tomasinfante/Diseno-Electrico-Capstone/Codigos/Raspberry/foto_20260909_120250.jpg

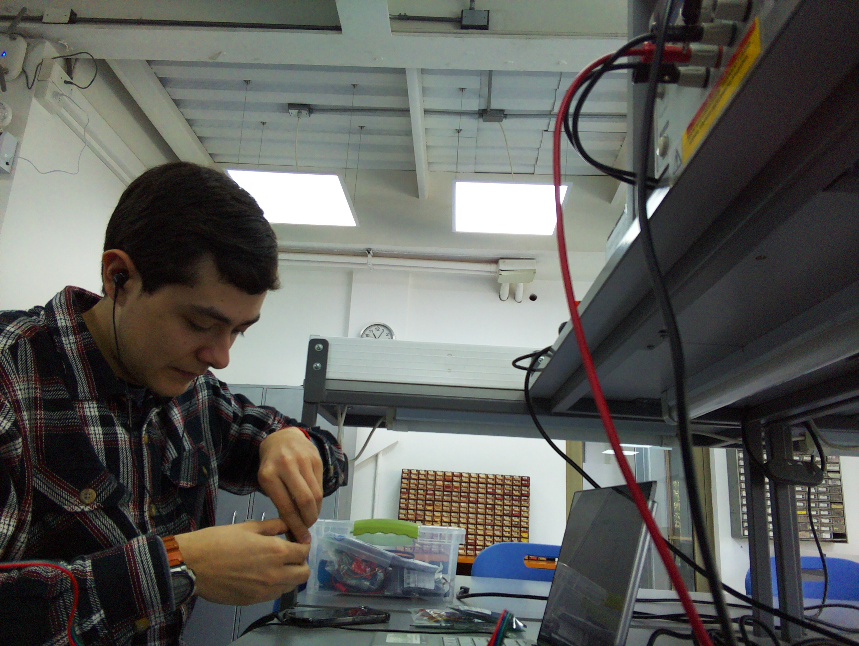
Codigos/Raspberry/foto_20260909_120250.jpg
