tomasinfante/Diseno-Electrico-Capstone/Entregas/Presentación Diseño y Planificación.pdf

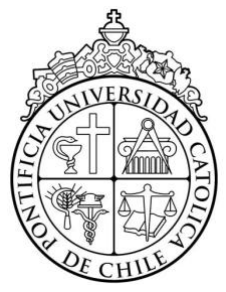
[picture p2: figure]

# Presentación Diseño y Planificación

Diseño Eléctrico – IEE2913 Profesor Tito Arévalo
Ayudantes Joaquín Bocaz y Andrés Mendoza

Grupo 8
Pablo del Campo
Tomás Infante
Juan Pablo Navarro

## Sistema Pan-Tilt para seguimiento automático

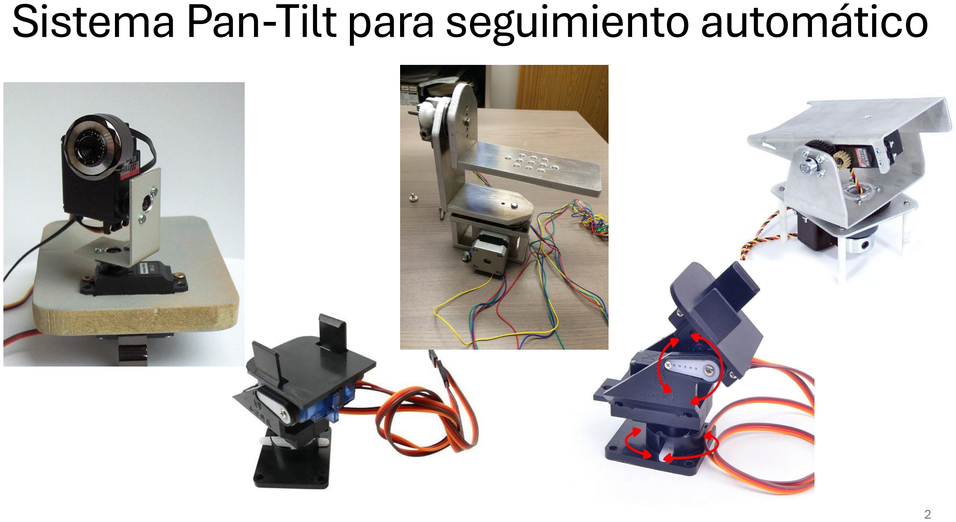
[picture p3: page 2]

## Requerimientos

Movimiento | Seguimiento | Robustez | Monitoreo
Pan + Tilt | Objeto móvil | Oclusión/Perturbación | Variables del sistema
180° por eje | Control automático | Operación segura | Registro de datos

Nuestro problema prioriza posicionamiento controlado, seguimiento y robustez.

## Arquitectura Mecánica

Priorizamos control robusto e independiente por eje

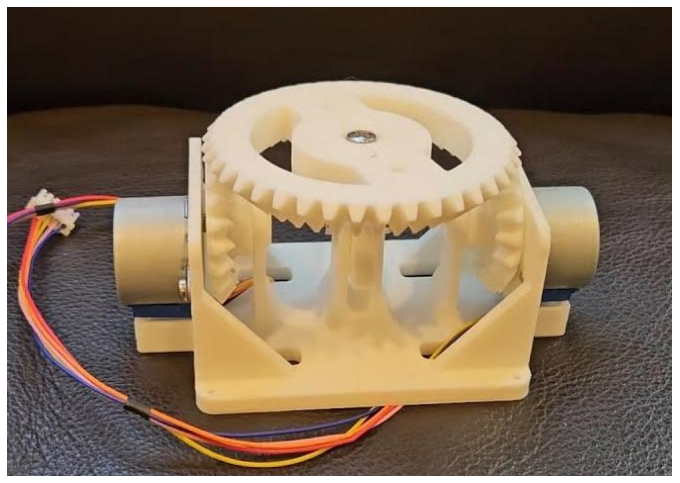
[picture p4: figure]
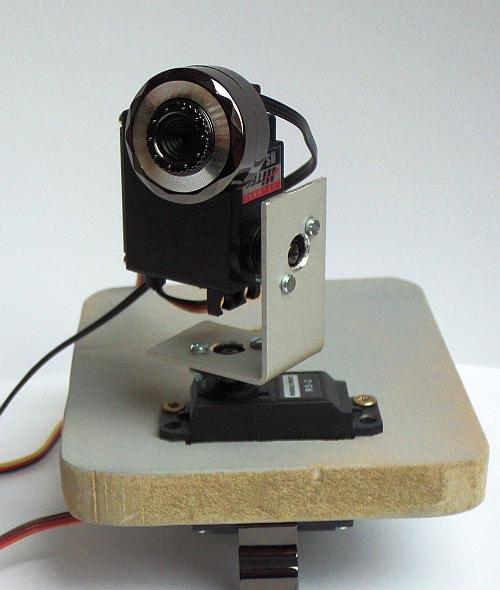
[picture p5: figure]

Diferencial | Independiente
Mejor reparto de la carga | Control desacoplado
Movimiento combinado naturalmente | Diagnostico modular
Mayor complejidad de control | Implementación 3D compleja

## Actuadores

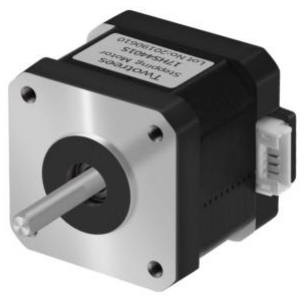
[picture p6: figure]

Motor | Movimiento | Desempeño a baja velocidad | Consideraciones

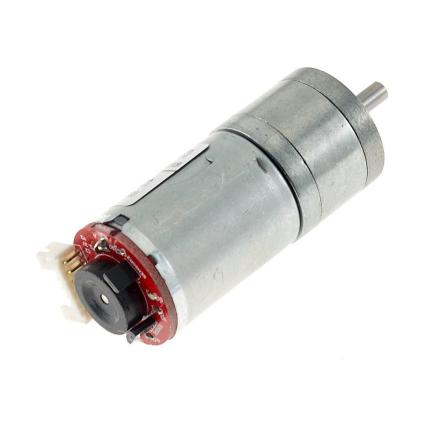
[picture p7: figure]

Paso a paso | Incremental | Alto | Cambios poco precisos en posición a falta de pasos
DC | Continuo | Bajo | Requiere de caja reductora

La aplicación prioriza posicionamiento, no alta velocidad

## ¿Por qué NEMA 17 17HS4401?

- Suficiente capacidad sin
sobredimensionar
- 40 N·cm es un torque adecuado

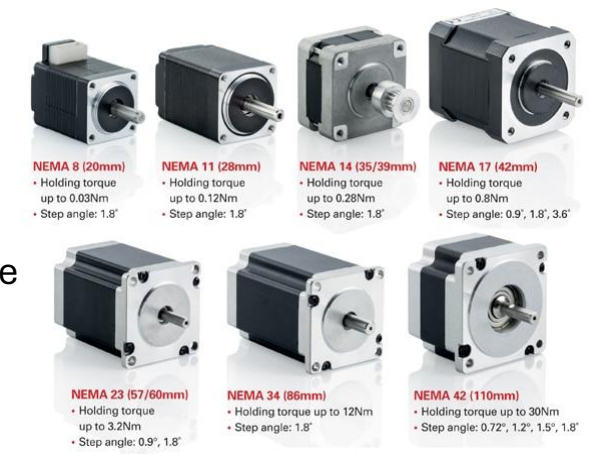
[picture p8: figure]

- 1,5 A/fase nos deja una electronica de potencia manejable
- 1,8°/paso entrega margen de angulo bajo y reducible con microstepping

## Sensor AS5600

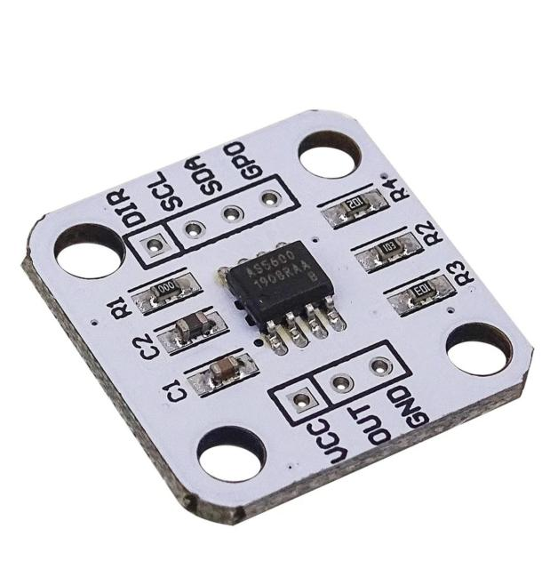
[picture p9: figure]
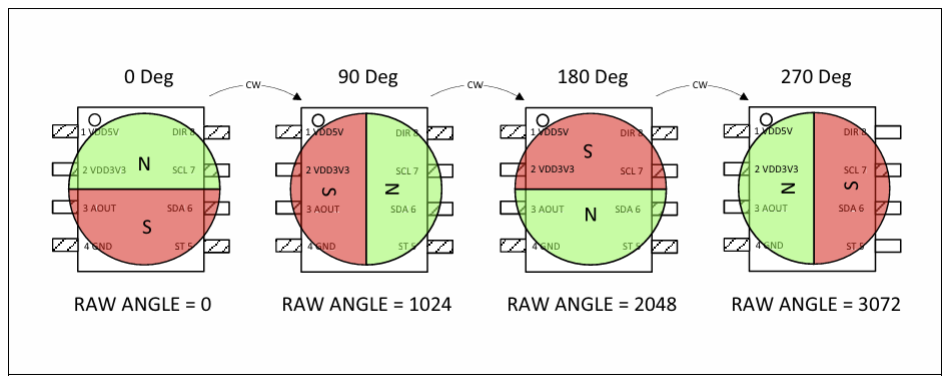
[picture p10: figure]

- 12 bits de resolución para medición de posición.
- Comunicación por medio de I2C
- Gran compatibilidad con motor 17HS4401

## Driver: DRV8825

Actuación y sensado con granularidades compatibles
- Soporte de hasta 2.5 A
- Buen comportamiento
y sinergia con steppers

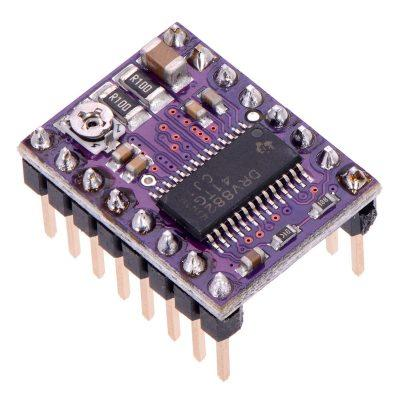
[picture p11: figure]

- Uso de DIR/STEP
- 1/32 microstepping
- 0.056° de resolución

## Bosquejos de Solución

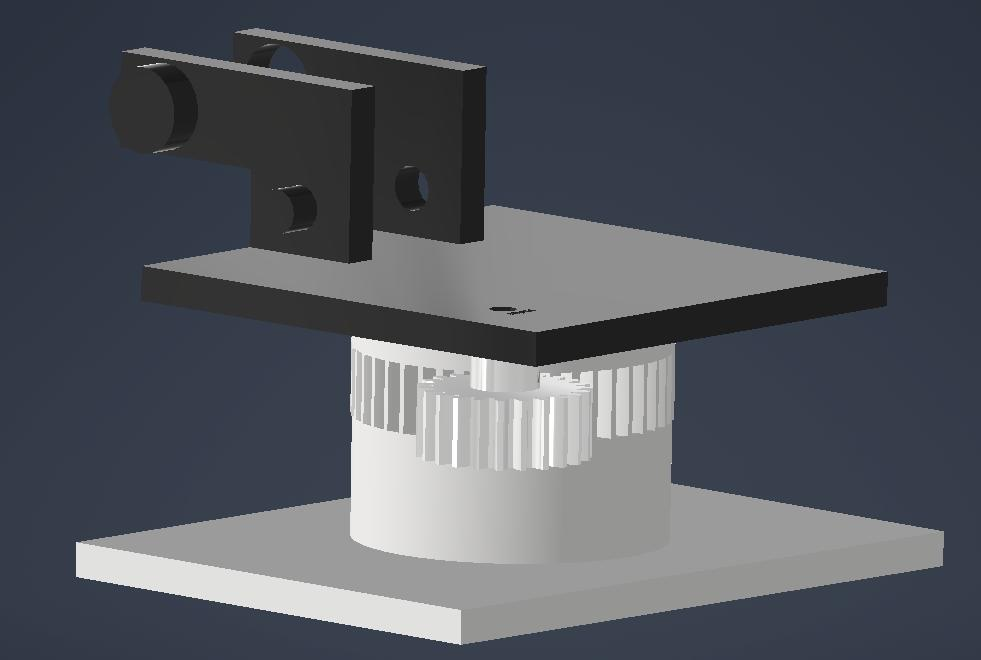
[picture p12: figure]

## Bosquejos de Solución

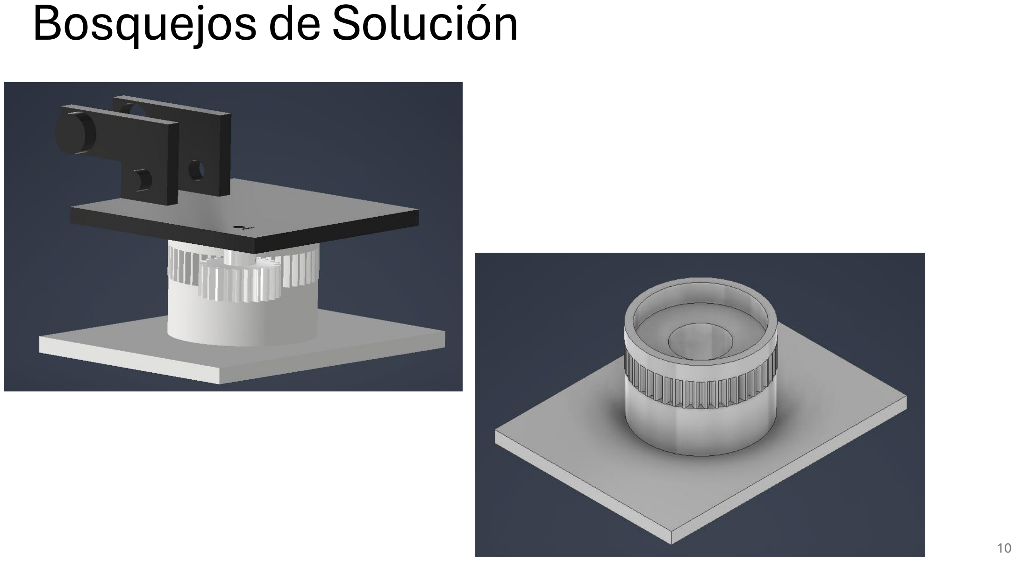
[picture p13: page 10]

## Bosquejos de Solución

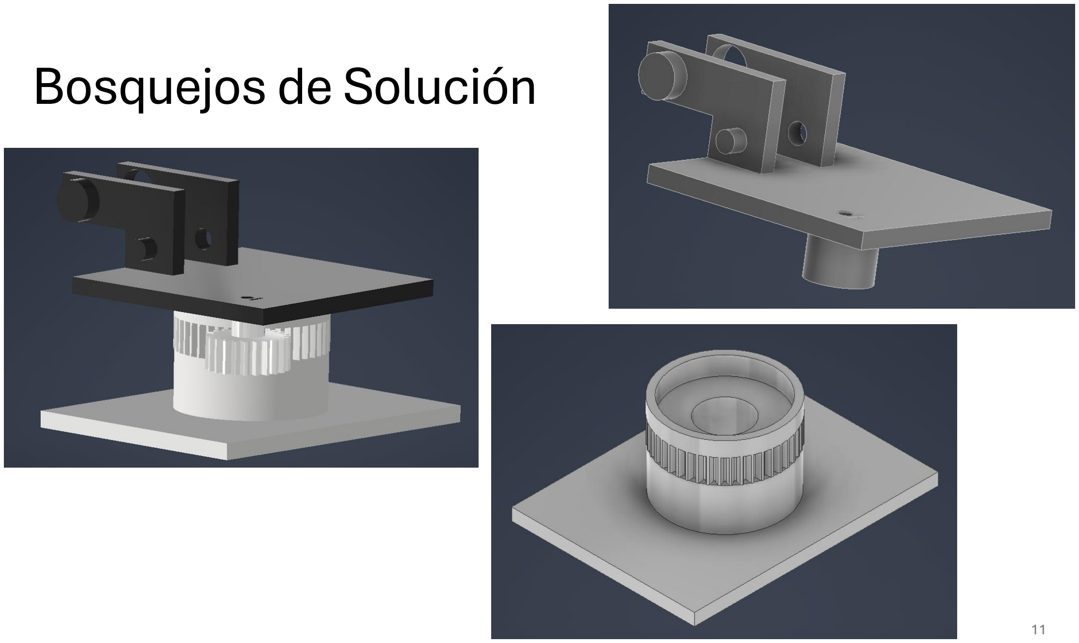
[picture p14: page 11]

## Diagrama del Sistema

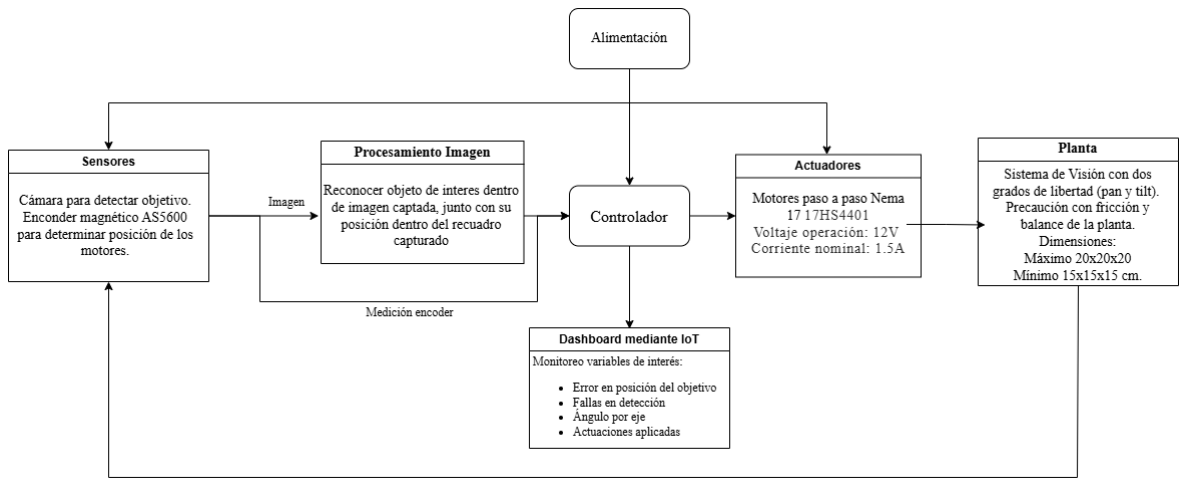
[picture p15: figure]

## Planificación semestral

### Avance 1: Definición formal Sistema

### Avance 2: Implementación Sistema Físico Preliminar

### Avance 3: Implementación de Control

### Entrega final: Prototipo totalmente funcional

## Avance 5%

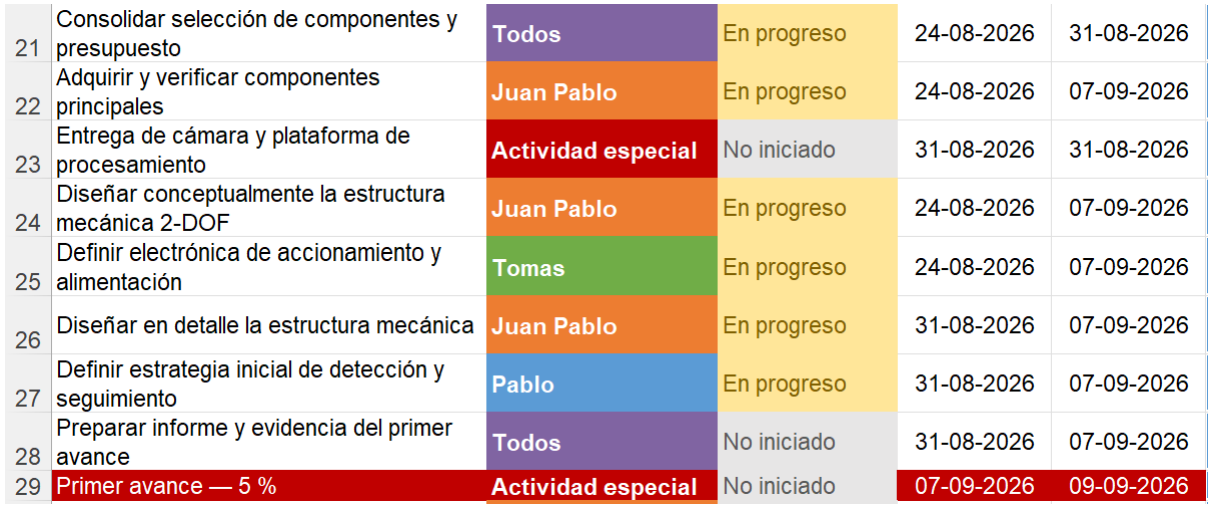
[picture p16: figure]

## Avance 25%

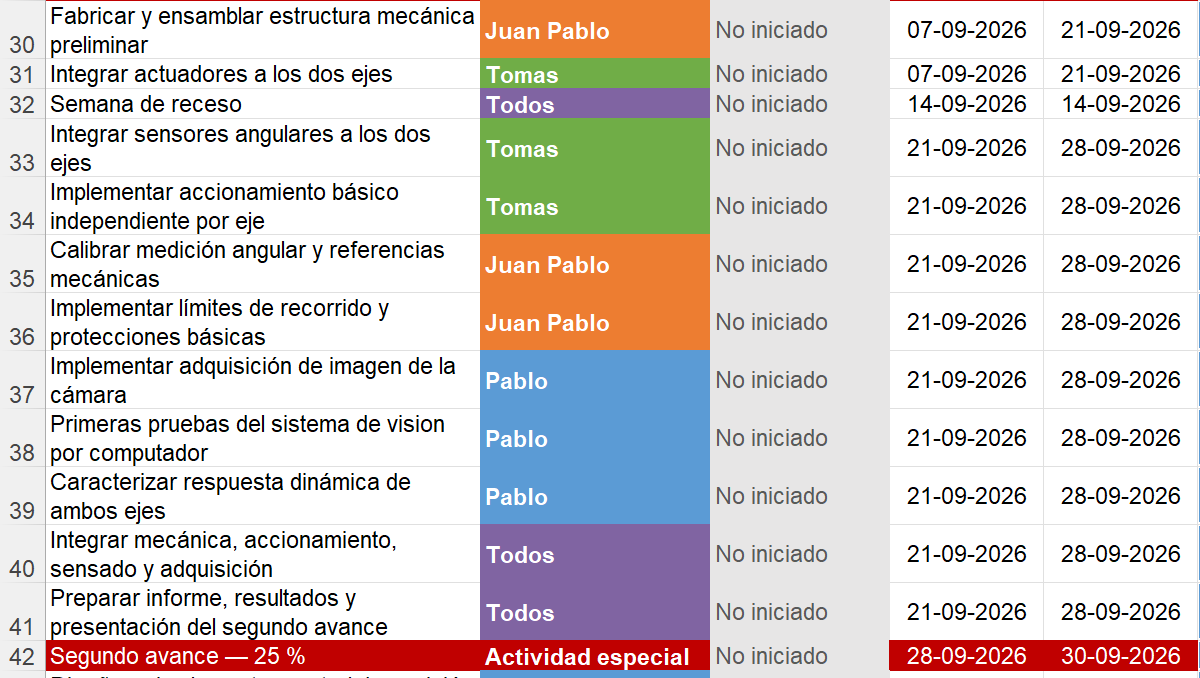
[picture p17: figure]

## Avance 60%

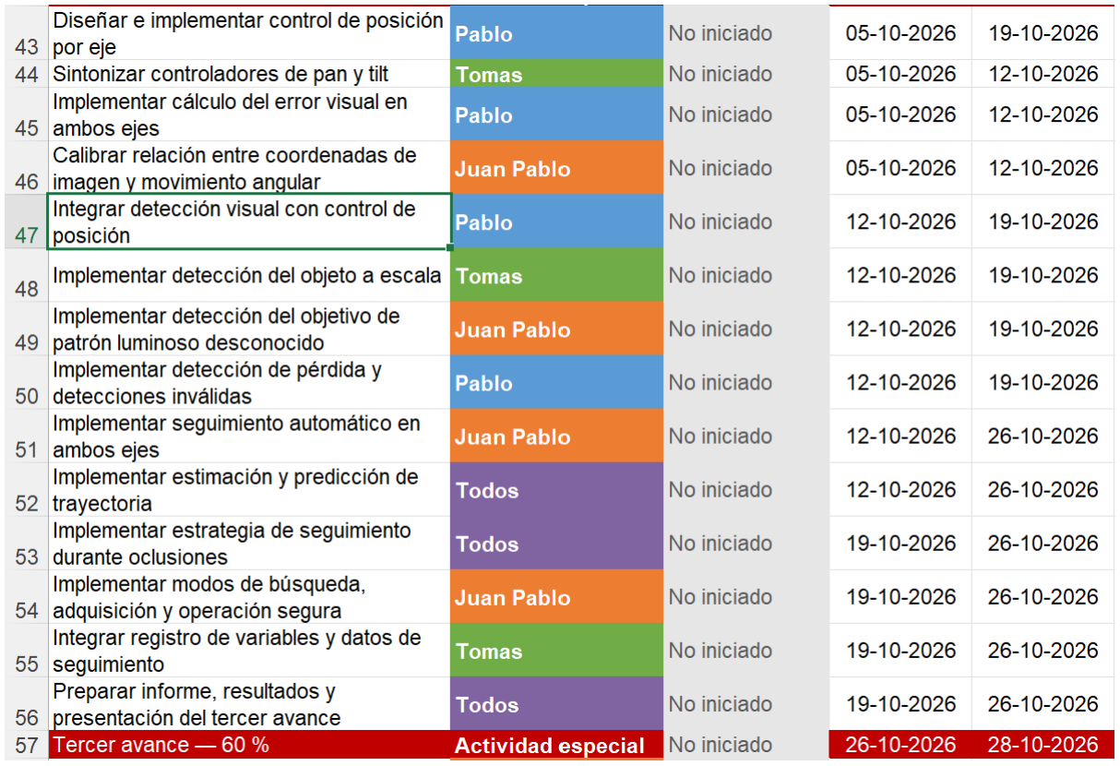
[picture p18: figure]

## Presentación final

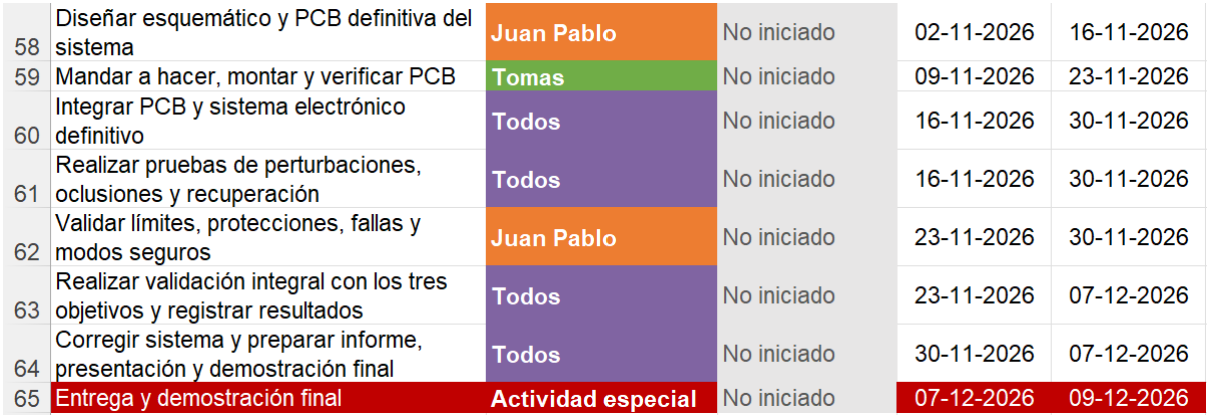
[picture p19: figure]
