tomasinfante/Diseno-Electrico-Capstone/Entregas/tabla_frecuencia_comms.tex

% Estadísticas del periodo de comunicación (datos comms.txt)
% N = 580 muestras con objetivo detectado; se excluyen 2 muestras "Sin objetivo" (0 Hz)
% Periodo calculado por muestra como T = 1/f
\begin{table}[htbp]
    \centering
    \caption{Estadísticas del periodo de comunicación ($N = 580$ muestras).}
    \label{tab:periodo_comms}
    \begin{tabular}{lc}
        \hline
        \textbf{Métrica} & \textbf{Valor [ms]} \\
        \hline
        Promedio            & 21,56 \\
        Desviación estándar & 6,53 \\
        Máximo              & 100,00 \\
        Mínimo              & 16,67 \\
        \hline
    \end{tabular}
\end{table}
