tomasinfante/Diseno-Electrico-Capstone/Entregas/tabla_periodo_mayor_21ms.tex

% Muestras con periodo de comunicación mayor a 21 ms (datos comms.txt)
% N = 580 muestras con objetivo detectado; se excluyen 2 muestras "Sin objetivo" (0 Hz)
% Periodo calculado por muestra como T = 1/f; porcentajes respecto de N
\begin{table}[htbp]
    \centering
    \caption{Muestras con periodo de comunicación mayor a 21~ms ($N = 580$ muestras).}
    \label{tab:periodo_mayor_21ms}
    \begin{tabular}{cccc}
        \hline
        \textbf{Frecuencia [Hz]} & \textbf{Periodo [ms]} & \textbf{Muestras} & \textbf{Porcentaje [\%]} \\
        \hline
        40 & 25,0  & 67 & 11,6 \\
        30 & 33,3  & 18 & 3,1  \\
        20 & 50,0  & 9  & 1,6  \\
        10 & 100,0 & 2  & 0,3  \\
        \hline
        \multicolumn{2}{c}{\textbf{Total}} & \textbf{96} & \textbf{16,6} \\
        \hline
    \end{tabular}
\end{table}
