tomasinfante/Diseno-Electrico-Capstone/Carta_Gantt_Diseno_Electrico_Capstone_FUNCIONAL.xlsx

DISEÑO ELÉCTRICO (CAPSTONE) — CARTA GANTT
Plan de trabajo · 3 integrantes · 18 semanas · Inicio: semana del 10 de agosto · S17: semana del 30 de noviembre
 |  |  |  |  |  | 2026-08-10 | 2026-08-17 | 2026-08-24 | 2026-08-31 | 2026-09-07 | 2026-09-14 | 2026-09-21 | 2026-09-28 | 2026-10-05 | 2026-10-12 | 2026-10-19 | 2026-10-26 | 2026-11-02 | 2026-11-09 | 2026-11-16 | 2026-11-23 | 2026-11-30 | 2026-12-07
Actividad | Responsable | Estado | Inicio | Fin | % avance | S1 10/08 | S2 17/08 | S3 24/08 | S4 31/08 | S5 07/09 | S6 14/09 | S7 21/09 | S8 28/09 | S9 05/10 | S10 12/10 | S11 19/10 | S12 26/10 | S13 02/11 | S14 09/11 | S15 16/11 | S16 23/11 | S17 30/11 | S18 07/12
Analizar requisitos y restricciones del proyecto | Todos | Completado | 2026-08-10 | 2026-08-10 | 100%
Definir objetivos y alcance del sistema | Todos | Completado | 2026-08-10 | 2026-08-10 | 100%
Identificar subsistemas y arquitectura general | Todos | Completado | 2026-08-10 | 2026-08-17 | 100%
Distribuir responsabilidades y metodología de trabajo | Todos | Completado | 2026-08-10 | 2026-08-10 | 100%
Investigar alternativas de plataforma y actuadores | Juan Pablo | Completado | 2026-08-10 | 2026-08-17 | 100%
Investigar alternativas de sensado angular | Tomas | Completado | 2026-08-10 | 2026-08-17 | 100%
Investigar alternativas de cámara y procesamiento | Pablo | Completado | 2026-08-10 | 2026-08-17 | 100%
Elaborar arquitectura eléctrica y diagrama de bloques inicial | Pablo | Completado | 2026-08-17 | 2026-08-24 | 100%
Elaborar planificación, Carta Gantt y estrategia de validación | Todos | Completado | 2026-08-10 | 2026-08-24 | 100%
Seleccionar actuadores para pan y tilt | Tomas | Completado | 2026-08-17 | 2026-08-24 | 100%
Seleccionar sensores de posición angular | Tomas | Completado | 2026-08-17 | 2026-08-24 | 100%
Definir rangos angulares y límites de ambos ejes | Tomas | Completado | 2026-08-17 | 2026-08-24 | 100%
Preparar informe y presentación de diseño y planificación | Todos | En progreso | 2026-08-17 | 2026-08-24 | 90%
Entrega diseño y planificación | Actividad especial | No iniciado | 2026-08-24 | 2026-08-26 | 0%
Consolidar selección de componentes y presupuesto | Todos | En progreso | 2026-08-24 | 2026-08-31 | 70%
Adquirir y verificar componentes principales | Juan Pablo | En progreso | 2026-08-24 | 2026-09-07 | 50%
Entrega de cámara y plataforma de procesamiento | Actividad especial | No iniciado | 2026-08-31 | 2026-08-31 | 0%
Diseñar conceptualmente la estructura mecánica 2-DOF | Juan Pablo | En progreso | 2026-08-24 | 2026-09-07 | 70%
Definir electrónica de accionamiento y alimentación | Tomas | En progreso | 2026-08-24 | 2026-09-07 | 60%
Diseñar en detalle la estructura mecánica | Juan Pablo | En progreso | 2026-08-31 | 2026-09-07 | 30%
Definir estrategia inicial de detección y seguimiento | Pablo | En progreso | 2026-08-31 | 2026-09-07 | 30%
Preparar informe y evidencia del primer avance | Todos | No iniciado | 2026-08-31 | 2026-09-07 | 0%
Primer avance — 5 % | Actividad especial | No iniciado | 2026-09-07 | 2026-09-09 | 0%
Fabricar y ensamblar estructura mecánica preliminar | Juan Pablo | No iniciado | 2026-09-07 | 2026-09-21 | 0%
Integrar actuadores a los dos ejes | Tomas | No iniciado | 2026-09-07 | 2026-09-21 | 0%
Semana de receso | Todos | No iniciado | 2026-09-14 | 2026-09-14 | 0%
Integrar sensores angulares a los dos ejes | Tomas | No iniciado | 2026-09-21 | 2026-09-28 | 0%
Implementar accionamiento básico independiente por eje | Tomas | No iniciado | 2026-09-21 | 2026-09-28 | 0%
Calibrar medición angular y referencias mecánicas | Juan Pablo | No iniciado | 2026-09-21 | 2026-09-28 | 0%
Implementar límites de recorrido y protecciones básicas | Juan Pablo | No iniciado | 2026-09-21 | 2026-09-28 | 0%
Implementar adquisición de imagen de la cámara | Pablo | No iniciado | 2026-09-21 | 2026-09-28 | 0%
Primeras pruebas del sistema de vision por computador | Pablo | No iniciado | 2026-09-21 | 2026-09-28 | 0%
Caracterizar respuesta dinámica de ambos ejes | Pablo | No iniciado | 2026-09-21 | 2026-09-28 | 0%
Integrar mecánica, accionamiento, sensado y adquisición | Todos | No iniciado | 2026-09-21 | 2026-09-28 | 0%
Preparar informe, resultados y presentación del segundo avance | Todos | No iniciado | 2026-09-21 | 2026-09-28 | 0%
Segundo avance — 25 % | Actividad especial | No iniciado | 2026-09-28 | 2026-09-30 | 0%
Diseñar e implementar control de posición por eje | Pablo | No iniciado | 2026-10-05 | 2026-10-19 | 0%
Sintonizar controladores de pan y tilt | Tomas | No iniciado | 2026-10-05 | 2026-10-12 | 0%
Implementar cálculo del error visual en ambos ejes | Pablo | No iniciado | 2026-10-05 | 2026-10-12 | 0%
Calibrar relación entre coordenadas de imagen y movimiento angular | Juan Pablo | No iniciado | 2026-10-05 | 2026-10-12 | 0%
Integrar detección visual con control de posición | Pablo | No iniciado | 2026-10-12 | 2026-10-19 | 0%
Implementar detección del objeto a escala | Tomas | No iniciado | 2026-10-12 | 2026-10-19 | 0%
Implementar detección del objetivo de patrón luminoso desconocido | Juan Pablo | No iniciado | 2026-10-12 | 2026-10-19 | 0%
Implementar detección de pérdida y detecciones inválidas | Pablo | No iniciado | 2026-10-12 | 2026-10-19 | 0%
Implementar seguimiento automático en ambos ejes | Juan Pablo | No iniciado | 2026-10-12 | 2026-10-26 | 0%
Implementar estimación y predicción de trayectoria | Todos | No iniciado | 2026-10-12 | 2026-10-26 | 0%
Implementar estrategia de seguimiento durante oclusiones | Todos | No iniciado | 2026-10-19 | 2026-10-26 | 0%
Implementar modos de búsqueda, adquisición y operación segura | Juan Pablo | No iniciado | 2026-10-19 | 2026-10-26 | 0%
Integrar registro de variables y datos de seguimiento | Tomas | No iniciado | 2026-10-19 | 2026-10-26 | 0%
Preparar informe, resultados y presentación del tercer avance | Todos | No iniciado | 2026-10-19 | 2026-10-26 | 0%
Tercer avance — 60 % | Actividad especial | No iniciado | 2026-10-26 | 2026-10-28 | 0%
Diseñar esquemático y PCB definitiva del sistema | Juan Pablo | No iniciado | 2026-11-02 | 2026-11-16 | 0%
Mandar a hacer, montar y verificar PCB | Tomas | No iniciado | 2026-11-09 | 2026-11-23 | 0%
Integrar PCB y sistema electrónico definitivo | Todos | No iniciado | 2026-11-16 | 2026-11-30 | 0%
Realizar pruebas de perturbaciones, oclusiones y recuperación | Todos | No iniciado | 2026-11-16 | 2026-11-30 | 0%
Validar límites, protecciones, fallas y modos seguros | Juan Pablo | No iniciado | 2026-11-23 | 2026-11-30 | 0%
Realizar validación integral con los tres objetivos y registrar resultados | Todos | No iniciado | 2026-11-23 | 2026-12-07 | 0%
Corregir sistema y preparar informe, presentación y demostración final | Todos | No iniciado | 2026-11-30 | 2026-12-07 | 0%
Entrega y demostración final | Actividad especial | No iniciado | 2026-12-07 | 2026-12-09 | 0%
