tomasinfante/Diseno-Electrico-Capstone/Rubrica_informe_avance.xlsx

Grupo XX | Excelente | Bien | Adecuado | Deficiente | Insuficiente o inexistente
Diagrama de bloques de bajo nivel |  |  |  |  |  | 30 | 30%
Presenta claramente el diagrama de bloques de bajo nivel: fuentes de energía, conexiones entre bloques, especificaciones y características de los bloques. Descripción de bloques. | 1 |  |  |  |  | 10
Los bloques son subdivisiones de bloques de mayor jerarquía, cumplen la funcionalidad correspondiente y tienen especificaciones claras. | 1 |  |  |  |  | 10
Las conexiones entre bloques están precisamente definidas | 1 |  |  |  |  | 10
Elección de componentes críticas |  |  |  |  |  | 30 | 30%
Presenta la elección de componentes relevantes, debidamente descritas incluyendo sus características y especificaciones relevantes | 1 |  |  |  |  | 12
La elección de los componentes está debidamente justificada y se han elegido apropiadamente (permiten hacer lo que se requerirá de ellos) | 1 |  |  |  |  | 12
Indica el presupuesto, incluyendo el origen de los materiales (compra en el extranjero, compra en Chile, disponibles en el Fab-Lab, etc). | 1 |  |  |  |  | 6
Primer borrador de Diseño de Pruebas |  |  |  |  |  | 5 | 5%
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
