tomasinfante/Diseno-Electrico-Capstone/Diseños 3D/Encoder/AS5600Mount_nema17.stl

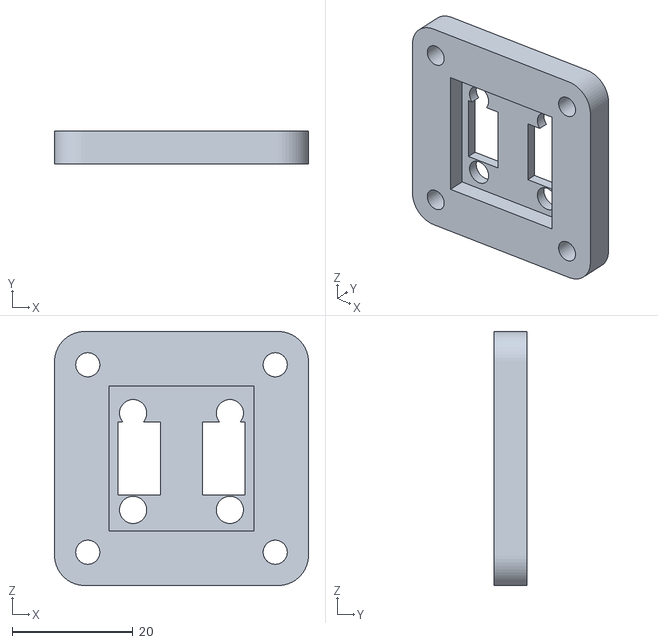
[picture p47: CAD file, 2026-09-05]
Diseños 3D/Encoder/AS5600Mount_nema17.stl
42.0 x 5.50 x 42.0
