tomasinfante/Diseno-Electrico-Capstone/Diseños 3D/pointer_nema_17_5mm_Shaft_v1.stl

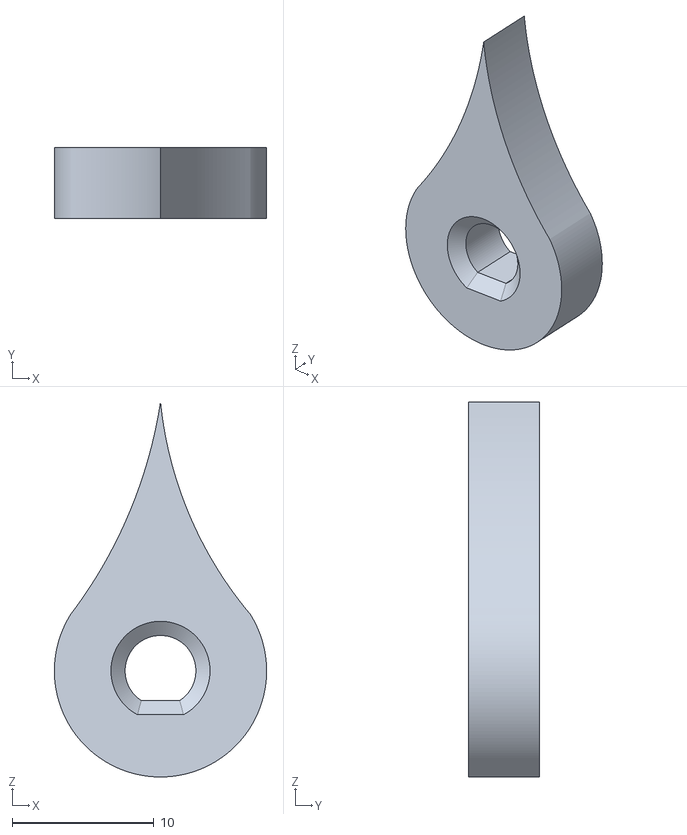
[picture p48: CAD file, 2026-09-05]
Diseños 3D/pointer_nema_17_5mm_Shaft_v1.stl
15.0 x 5.00 x 26.5
