tomasinfante/Diseno-Electrico-Capstone/Diseños 3D/Sliced/Archivos/BASE_V10.3mf

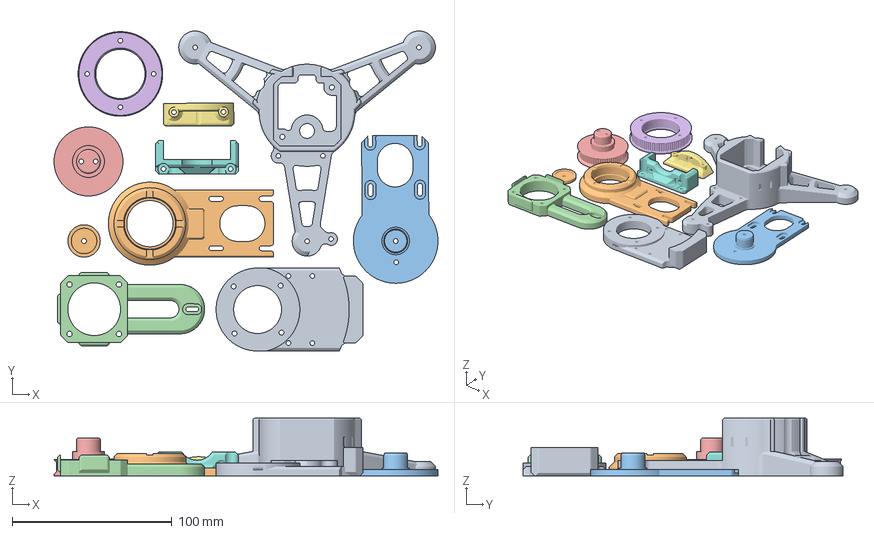
[picture p49: CAD file, 2026-09-08]
Diseños 3D/Sliced/Archivos/BASE_V10.3mf
240.6 x 200.5 x 36.3 mm
BASE_V10.stl
CAP_V10.stl
LOWER_ARM_PULLEY_SUPPORT_V10.stl
LOWER_ARM_V11_by_mikeq.stl
PULLEY_60_V10.stl
PULLEY_80_V10.stl
UPPER_ARM_MOTOR_HOLDER_LEFT_V10.stl
UPPER_ARM_MOTOR_HOLDER_RIGHT_V10.stl
UPPER_ARM_V10.stl
UPPER_ARM_VERTICAL_SUPPORT_V10.stl
