tomasinfante/Diseno-Electrico-Capstone/Diseños 3D/Torreta/base.step

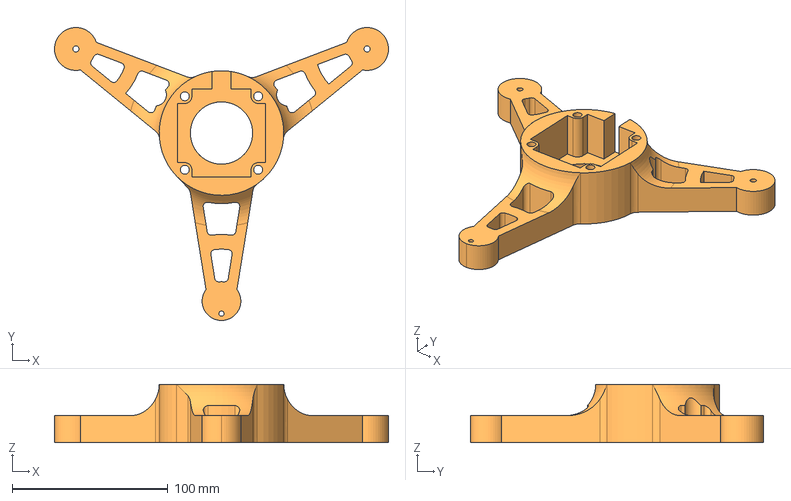
[picture p50: CAD file, 2026-09-08]
Diseños 3D/Torreta/base.step
214.5 x 188.1 x 37.3 mm
