tomasinfante/Diseno-Electrico-Capstone/Diseños 3D/Torreta_Original/jjRobots Laser-Torch pointer 3D models (STEP files).stp

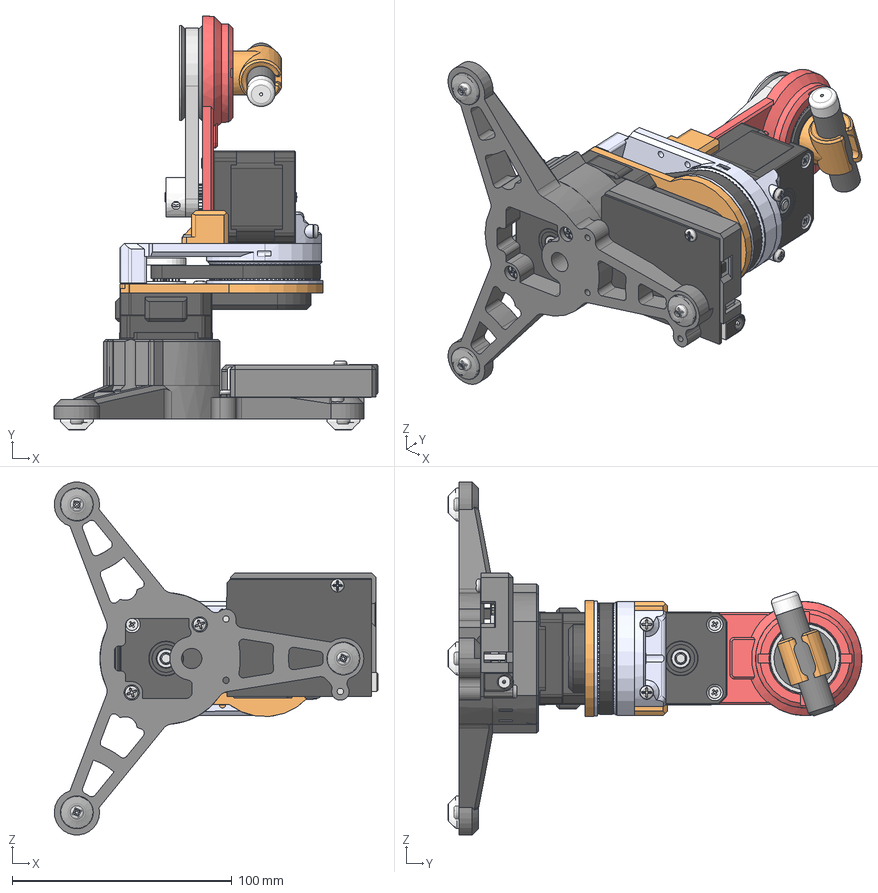
[picture p51: CAD file, 2026-09-08]
Diseños 3D/Torreta_Original/jjRobots Laser-Torch pointer 3D models (STEP files).stp
147.4 x 188.6 x 160.8 mm
17HM15-0904S
Motor ANGLE pasador
ARM
LASER HOLDER PASANTE
Bearing 6002 x 2
pulley 60 teeth
GT2_80T v2
GRANTY UP v2
NEMA17 x 2
GRANTY UP PASANTE para pulley 60 teeth
GT 5 20 Teeth Pulley M5 x 2
BASE NUEVA con soporte de DEVIAV5 v3
CAP
DEVIA board 3D mode CASEl
M3 bolt head x 24
RUBBER PADS x 3
