tomasinfante/Diseno-Electrico-Capstone/Diseños 3D/Torreta_Original/STL/PULLEY_80_V10.stl

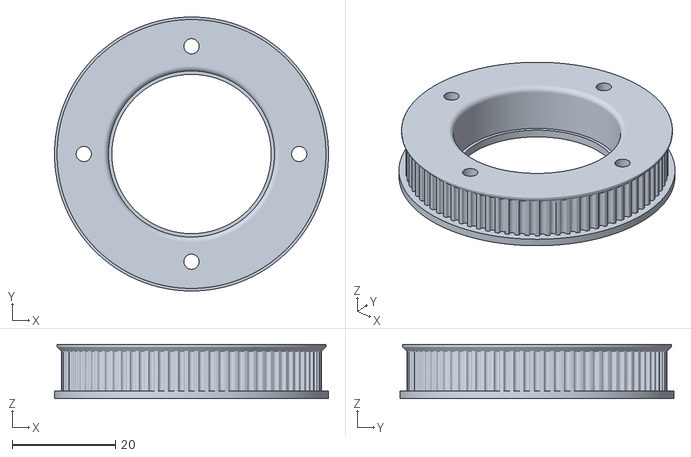
[picture p52: CAD file, 2026-09-08]
Diseños 3D/Torreta_Original/STL/PULLEY_80_V10.stl
53.0 x 53.0 x 10.5
