tomasinfante/Diseno-Electrico-Capstone/Diseños 3D/Sliced/Archivos/AS5600Mount_nema17.3mf

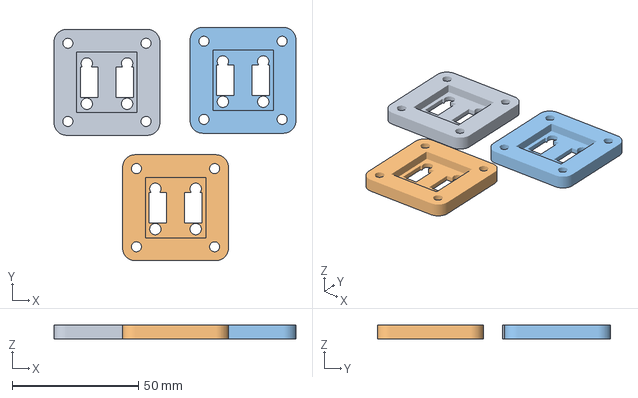
[picture p53: CAD file, 2026-09-05]
Diseños 3D/Sliced/Archivos/AS5600Mount_nema17.3mf
96.0 x 92.5 x 5.50 mm
AS5600Mount_nema17.stl x 3
