tomasinfante/Diseno-Electrico-Capstone/Diseños 3D/Torreta/pan-pulley-114t-gt2-pulley-9mm-wide.step

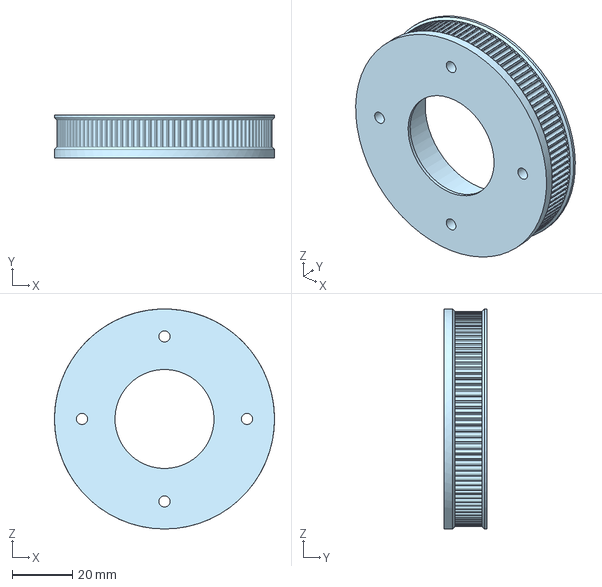
[picture p54: CAD file, 2026-09-08]
Diseños 3D/Torreta/pan-pulley-114t-gt2-pulley-9mm-wide.step
73.3 x 14.2 x 73.3 mm
