tomasinfante/Diseno-Electrico-Capstone/Diseños 3D/Torreta_Original/STL/UPPER_ARM_MOTOR_HOLDER_RIGHT_V10.stl

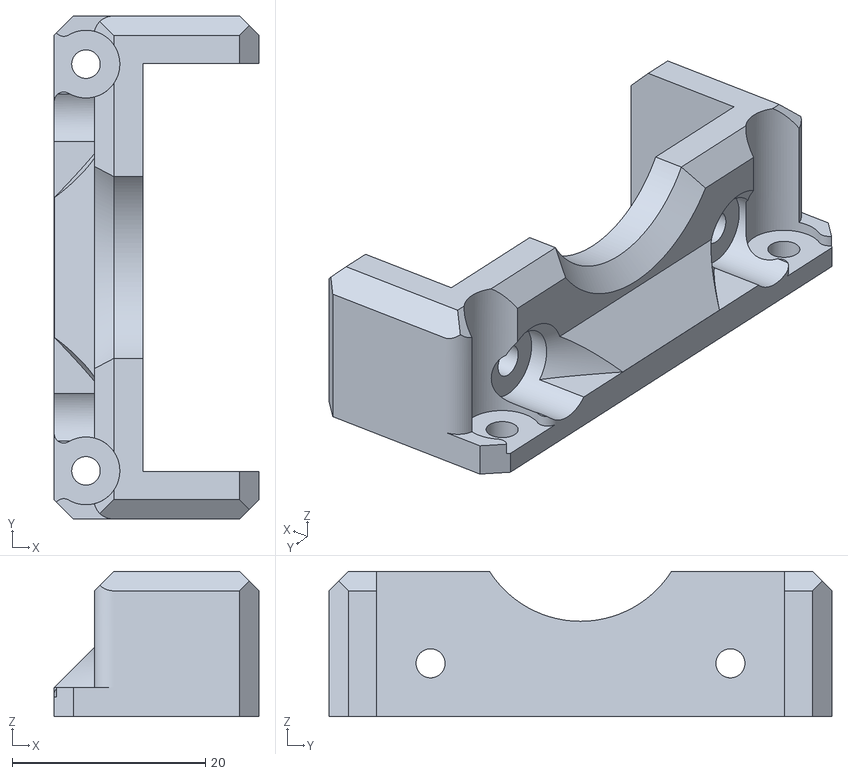
[picture p55: CAD file, 2026-09-08]
Diseños 3D/Torreta_Original/STL/UPPER_ARM_MOTOR_HOLDER_RIGHT_V10.stl
21.2 x 52.0 x 15.0
