tomasinfante/Diseno-Electrico-Capstone/Diseños 3D/Torreta/pan-endstop-mount.step

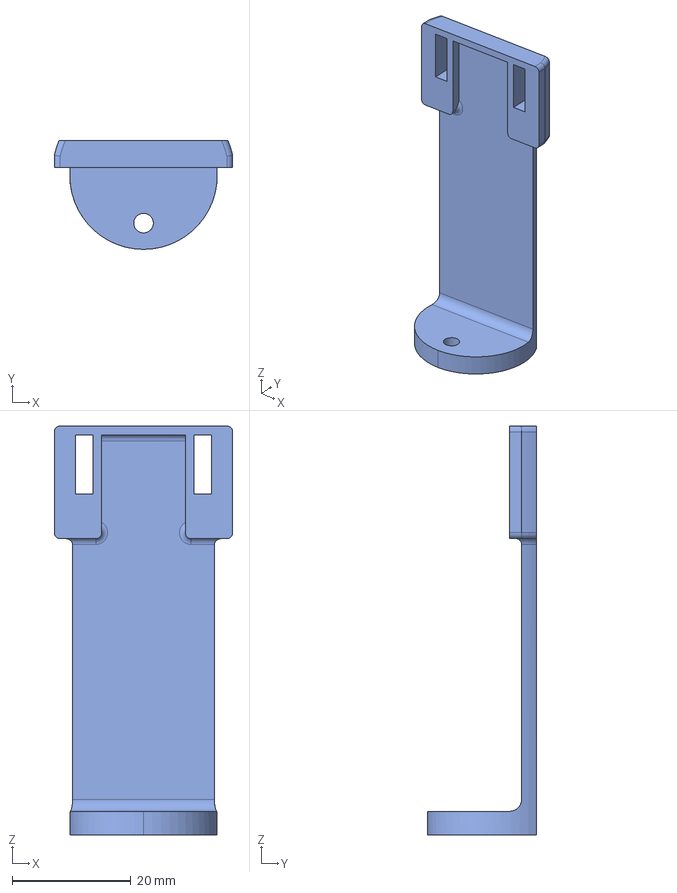
[picture p56: CAD file, 2026-09-08]
Diseños 3D/Torreta/pan-endstop-mount.step
30.1 x 18.4 x 69.0 mm
