tomasinfante/Diseno-Electrico-Capstone/Diseños 3D/Torreta_Original/STL/UPPER_ARM_V10.stl

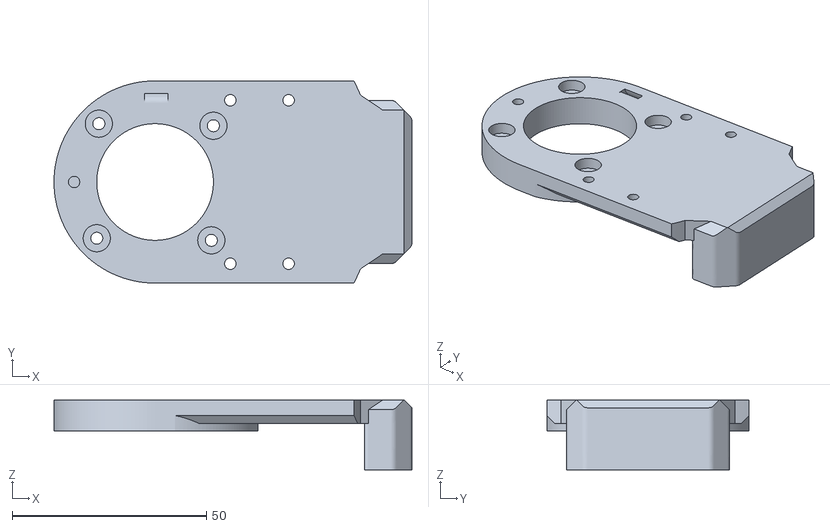
[picture p57: CAD file, 2026-09-08]
Diseños 3D/Torreta_Original/STL/UPPER_ARM_V10.stl
92.1 x 52.0 x 18.0
