tomasinfante/Diseno-Electrico-Capstone/Diseños 3D/Torreta/tilt-motor-brace.step

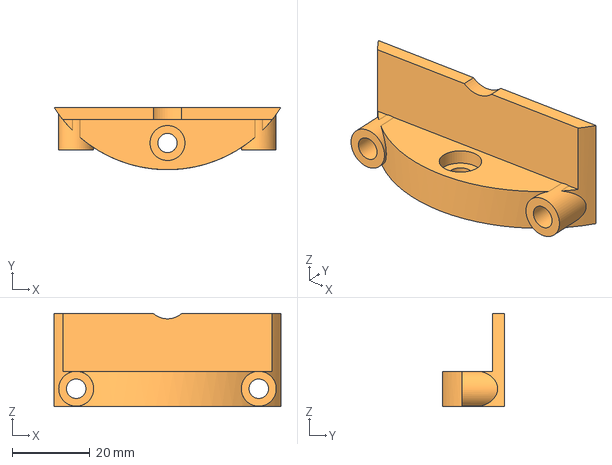
[picture p58: CAD file, 2026-09-08]
Diseños 3D/Torreta/tilt-motor-brace.step
58.4 x 16.1 x 24.0 mm
