tomasinfante/Diseno-Electrico-Capstone/Diseños 3D/Torreta_Original/STL/CAP_V10.stl

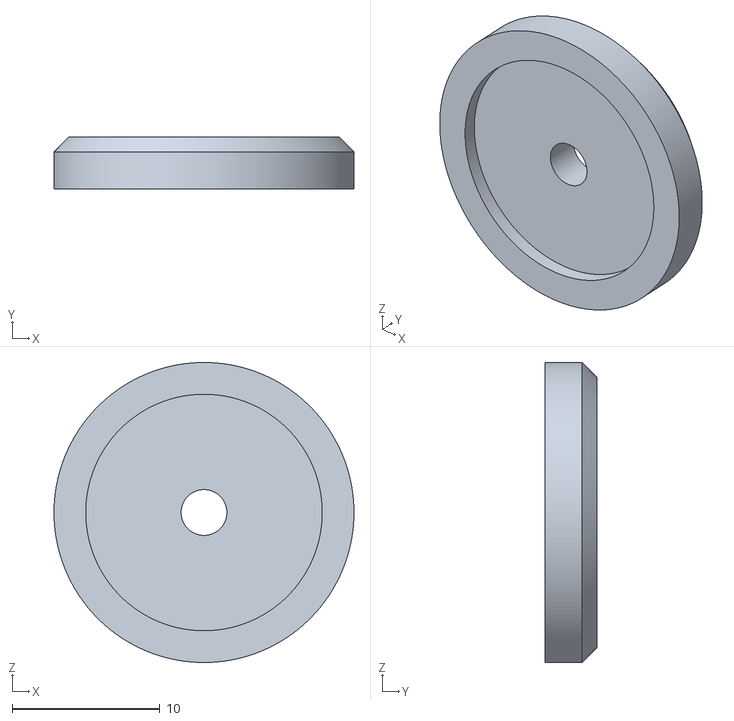
[picture p59: CAD file, 2026-09-08]
Diseños 3D/Torreta_Original/STL/CAP_V10.stl
20.3 x 3.50 x 20.3
