tomasinfante/Diseno-Electrico-Capstone/Diseños 3D/Torreta/tilt-endstop-triggers.step

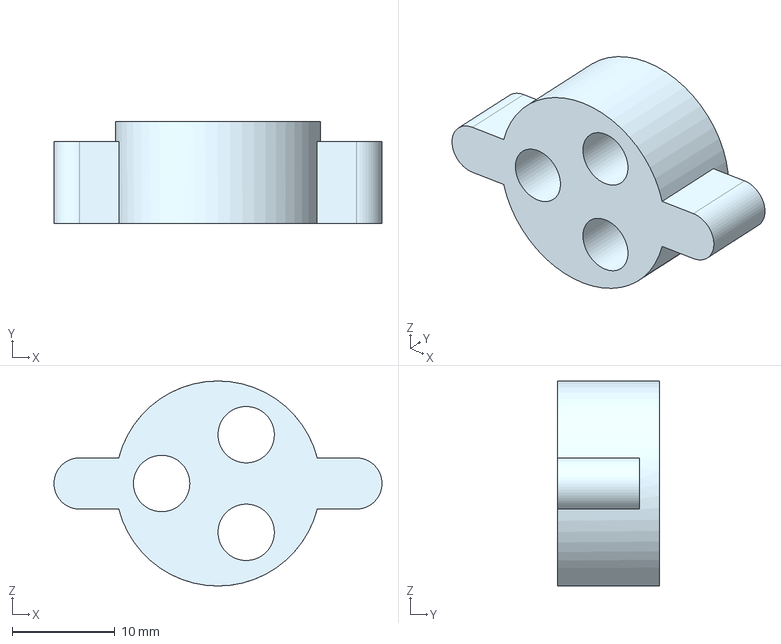
[picture p60: CAD file, 2026-09-08]
Diseños 3D/Torreta/tilt-endstop-triggers.step
32.0 x 10.0 x 20.0 mm
