tomasinfante/Diseno-Electrico-Capstone/Diseños 3D/Torreta_Original/STL/PULLEY_60_V10.stl

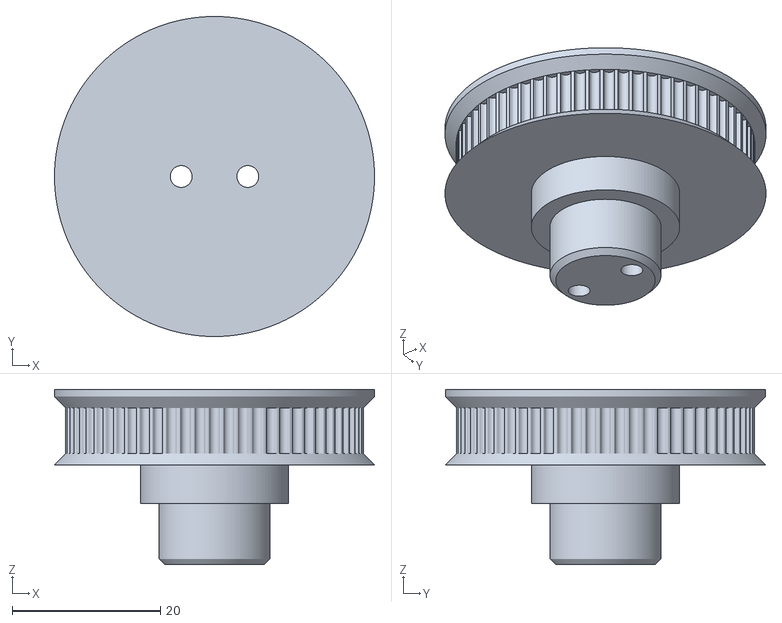
[picture p61: CAD file, 2026-09-08]
Diseños 3D/Torreta_Original/STL/PULLEY_60_V10.stl
43.2 x 43.2 x 23.7
