tomasinfante/Diseno-Electrico-Capstone/Diseños 3D/Torreta/sony-rx100-iii-mount.step

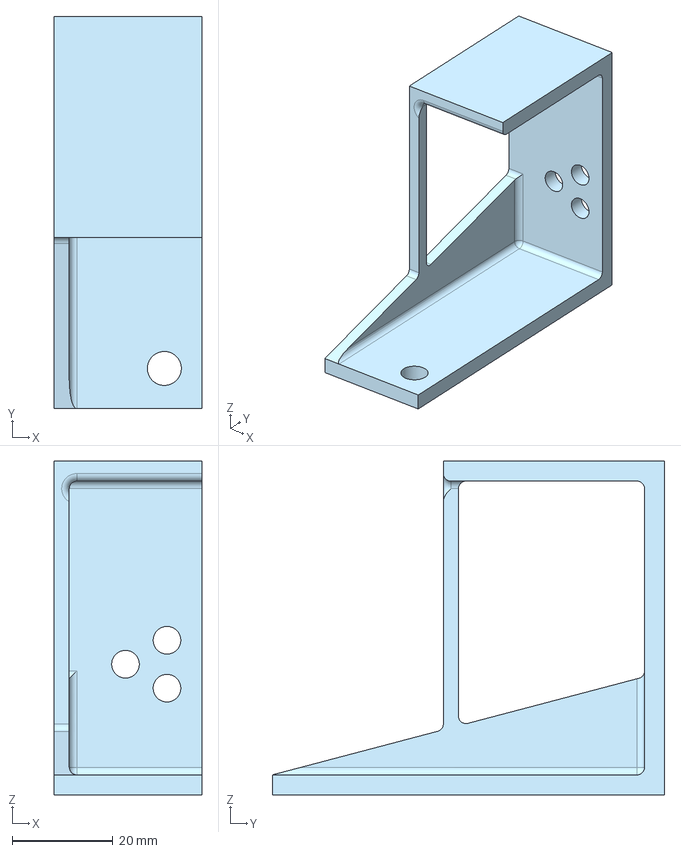
[picture p62: CAD file, 2026-09-08]
Diseños 3D/Torreta/sony-rx100-iii-mount.step
29.4 x 78.0 x 66.4 mm
