tomasinfante/Diseno-Electrico-Capstone/Diseños 3D/Torreta_Original/STL/LOWER_ARM_V10.stl

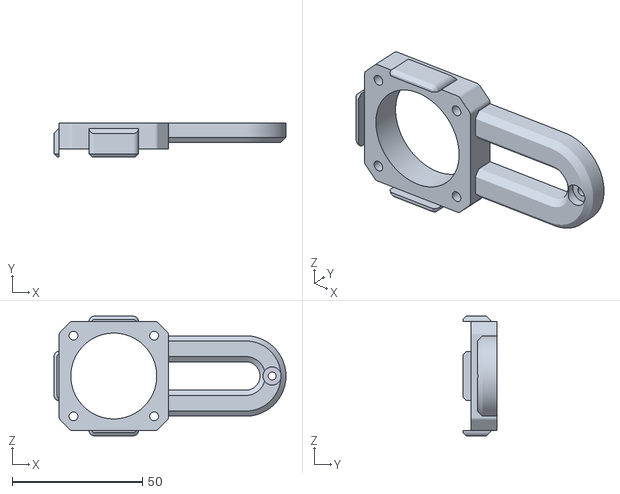
[picture p63: CAD file, 2026-09-08]
Diseños 3D/Torreta_Original/STL/LOWER_ARM_V10.stl
89.2 x 13.0 x 46.0
