tomasinfante/Diseno-Electrico-Capstone/Diseños 3D/Torreta/brace.step

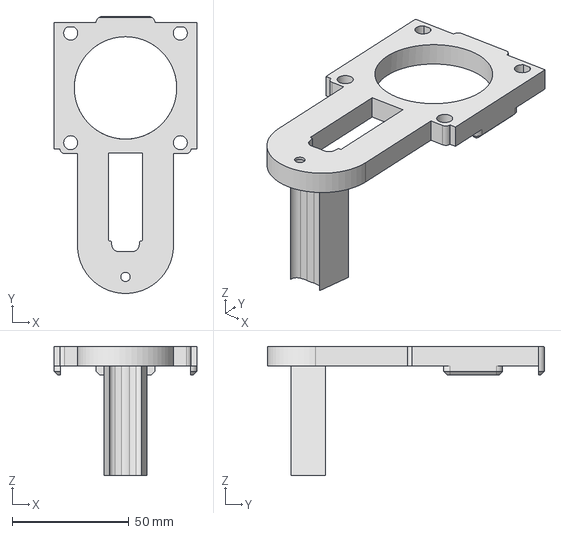
[picture p64: CAD file, 2026-09-08]
Diseños 3D/Torreta/brace.step
61.2 x 118.7 x 55.3 mm
