tomasinfante/Diseno-Electrico-Capstone/Diseños 3D/Torreta_Original/STL/LOWER_ARM_PULLEY_SUPPORT_V10.stl

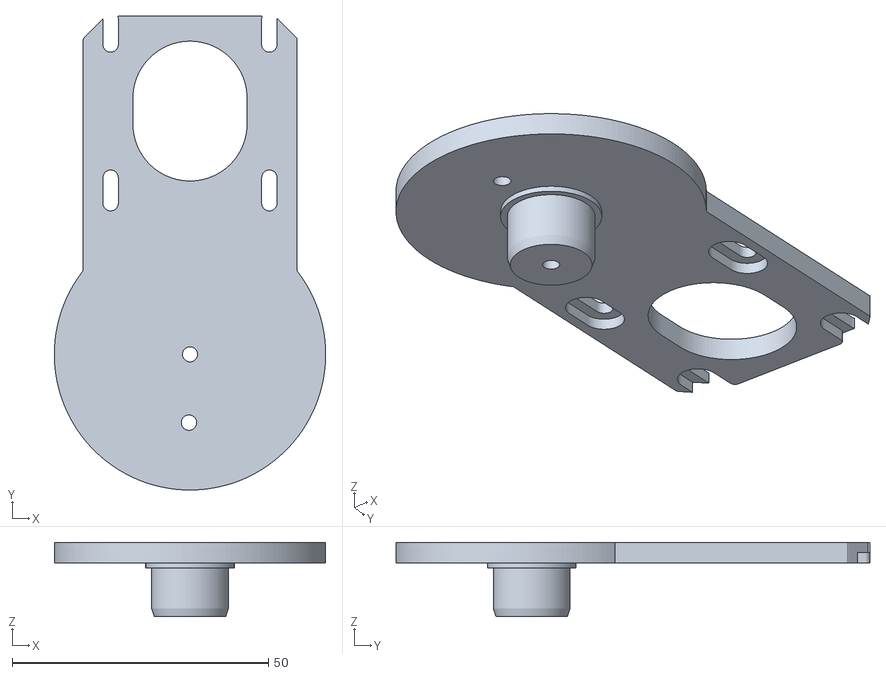
[picture p65: CAD file, 2026-09-08]
Diseños 3D/Torreta_Original/STL/LOWER_ARM_PULLEY_SUPPORT_V10.stl
53.0 x 92.6 x 14.5
