tomasinfante/Diseno-Electrico-Capstone/Diseños 3D/Torreta/tilt-arm-brace.step

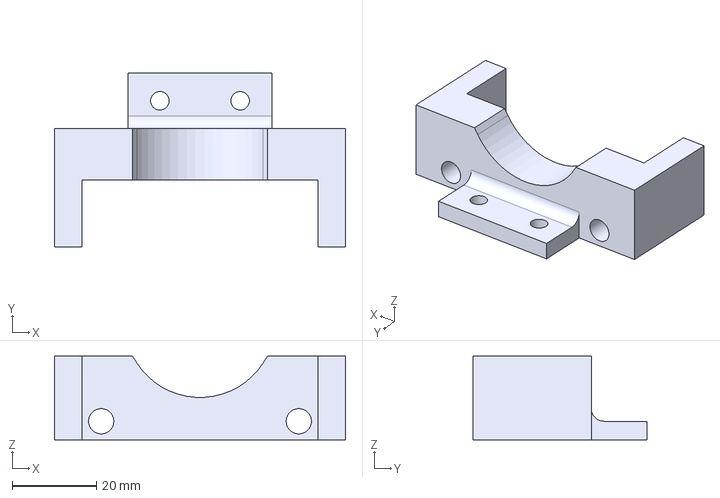
[picture p66: CAD file, 2026-09-08]
Diseños 3D/Torreta/tilt-arm-brace.step
69.2 x 41.4 x 20.0 mm
