tomasinfante/Diseno-Electrico-Capstone/Diseños 3D/Torreta_Original/STL/UPPER_ARM_MOTOR_HOLDER_LEFT_V10.stl

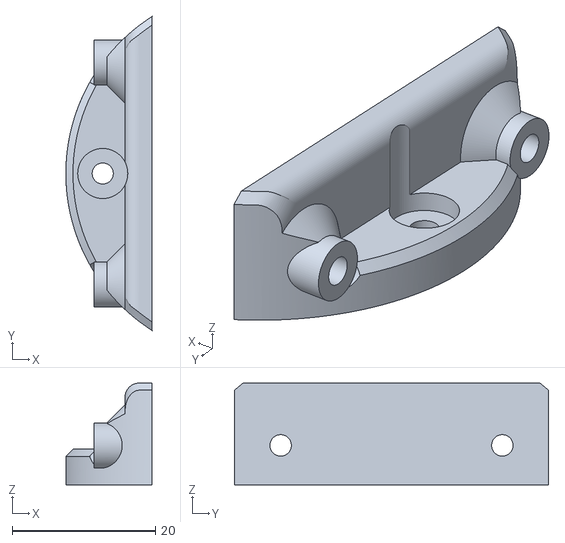
[picture p67: CAD file, 2026-09-08]
Diseños 3D/Torreta_Original/STL/UPPER_ARM_MOTOR_HOLDER_LEFT_V10.stl
12.1 x 43.9 x 14.2
