tomasinfante/Diseno-Electrico-Capstone/Diseños 3D/Torreta/pan-arm.step

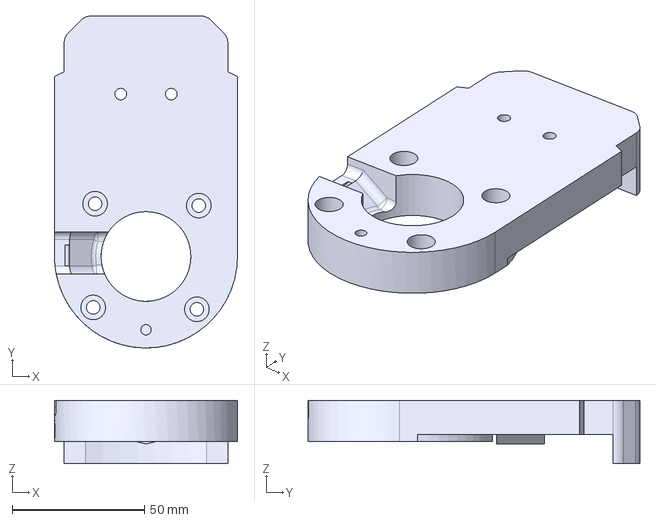
[picture p68: CAD file, 2026-09-08]
Diseños 3D/Torreta/pan-arm.step
69.2 x 125.6 x 24.0 mm
