tomasinfante/Diseno-Electrico-Capstone/Diseños 3D/Torreta_Original/STL/UPPER_ARM_VERTICAL_SUPPORT_V10.stl

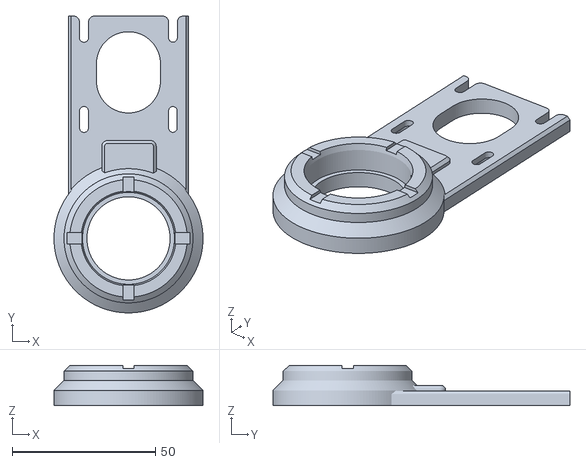
[picture p69: CAD file, 2026-09-08]
Diseños 3D/Torreta_Original/STL/UPPER_ARM_VERTICAL_SUPPORT_V10.stl
52.0 x 103.6 x 14.0
