tomasinfante/Diseno-Electrico-Capstone/Diseños 3D/Torreta/tilt-arm.step

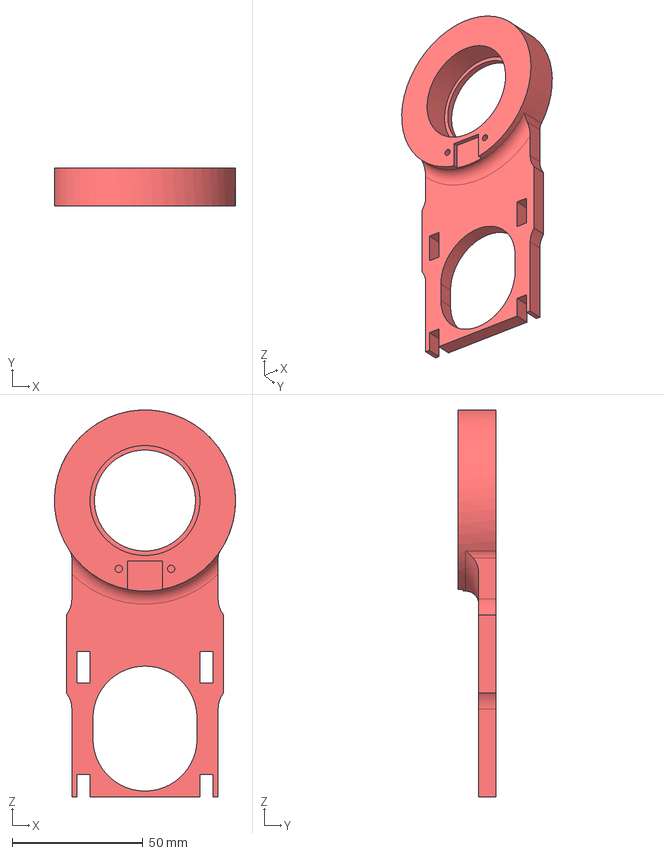
[picture p70: CAD file, 2026-09-08]
Diseños 3D/Torreta/tilt-arm.step
69.2 x 14.6 x 147.8 mm
