tomasinfante/Diseno-Electrico-Capstone/Diseños 3D/Torreta_Original/STL/BASE_V10.stl

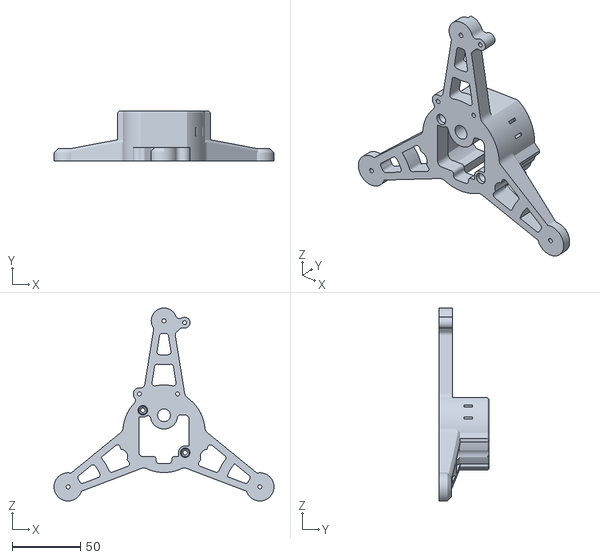
[picture p71: CAD file, 2026-09-08]
Diseños 3D/Torreta_Original/STL/BASE_V10.stl
160.8 x 36.3 x 141.1
