tomasinfante/Diseno-Electrico-Capstone/Diseños 3D/Torreta/pan-bearing-holder.step

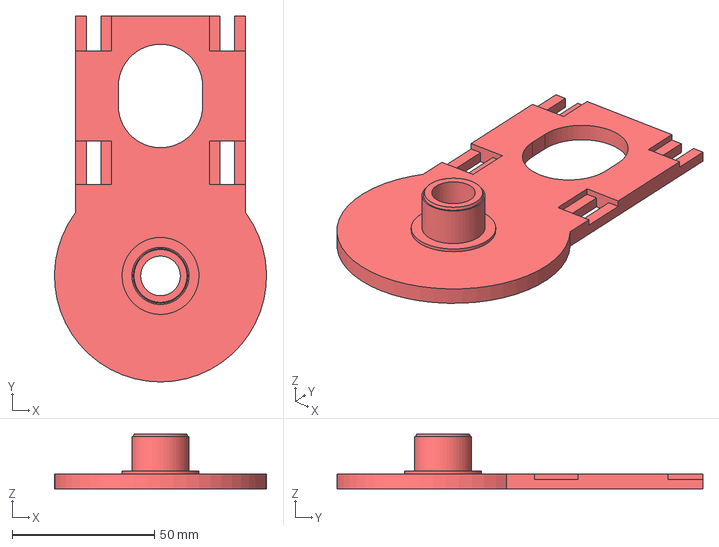
[picture p72: CAD file, 2026-09-08]
Diseños 3D/Torreta/pan-bearing-holder.step
74.5 x 128.6 x 19.3 mm
