tomasinfante/Diseno-Electrico-Capstone/Diseños 3D/Torreta_Original/STL/LOWER_ARM_V11_by_mikeq.stl

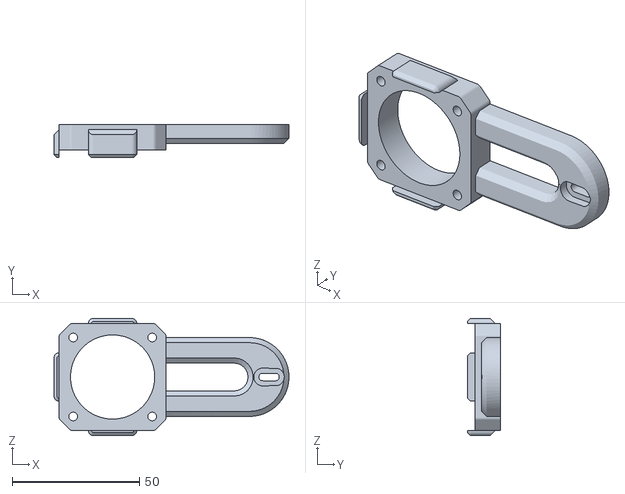
[picture p73: CAD file, 2026-09-08]
Diseños 3D/Torreta_Original/STL/LOWER_ARM_V11_by_mikeq.stl
92.2 x 13.0 x 46.0
