tomasinfante/Diseno-Electrico-Capstone/Diseños 3D/Torreta/tilt-pulley-mount.step

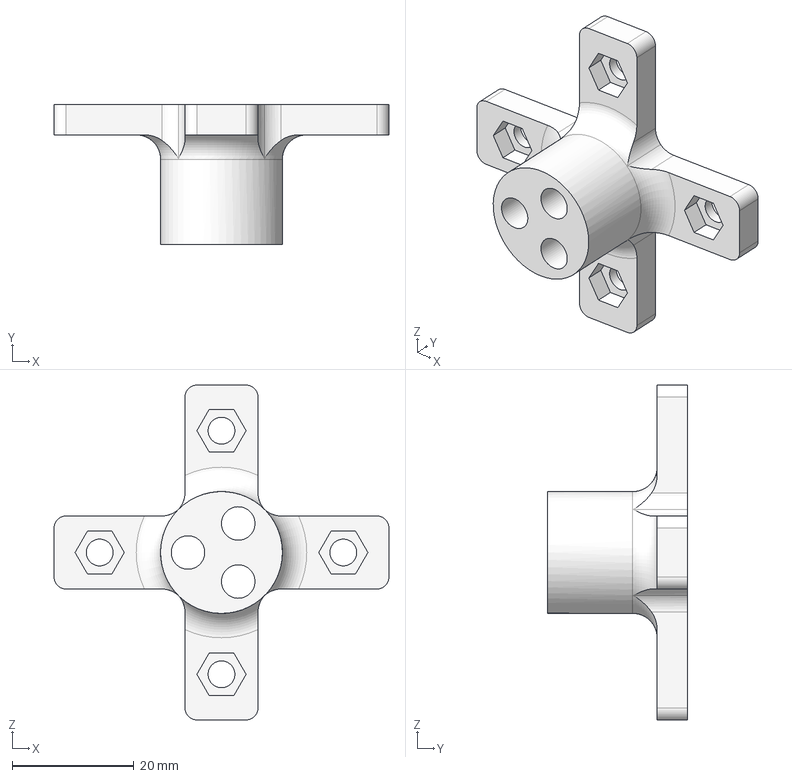
[picture p74: CAD file, 2026-09-08]
Diseños 3D/Torreta/tilt-pulley-mount.step
55.0 x 23.0 x 55.0 mm
