tomasinfante/Diseno-Electrico-Capstone/Diseños 3D/Torreta/tilt-pulley-98t-gt2-pulley-9mm-wide.step

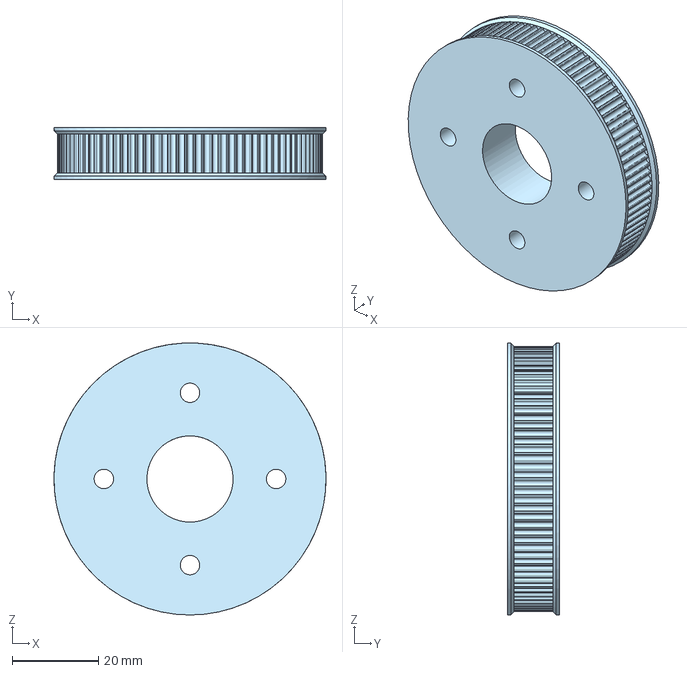
[picture p75: CAD file, 2026-09-08]
Diseños 3D/Torreta/tilt-pulley-98t-gt2-pulley-9mm-wide.step
63.1 x 12.2 x 63.1 mm
