tomasinfante/Diseno-Electrico-Capstone/Bitacora/Bitácora_Semana_4.docx

Bitácora semana 4

Actividades realizadas en la semana por Pablo Del Campo:

- Soldadura y testeo de enconder magnéticos (2 Horas)
- Describir la dinámica de la planta en el informe de avance 5% (4 Horas)
- Reunión equipo organización avances (2 horas)
- Creación repositorio (1 Hora)

Actividades realizadas en la semana por Juan Pablo Navarro:

- Cotización de posibles materiales para el proyecto (1 hora)

Actividades realizadas en la semana por Tomas Infante:

- Testeo de sensibilidad del encoder magnético. (2 Horas) Ver anexo
- Conectar todo el sistema de motor/encoder/esp32 para hacer pruebas durante la semana. (1 Horas)
- Reunión de equipo para organizar temas varios (2 Horas)
- Avanzar en la parte de cotizaciones para el informe 5% (3 Horas)
- Investigar plataformas y componentes para su construcción. (2 Hora)
- Creación repositorio (1 Hora)

Actividades a realizar la próxima semana por Pablo Del Campo:

- Prueba de sistema de visión
- Definir estrategia inicial de detección y seguimiento

Actividades a realizar la próxima semana por Juan Pablo Navarro:

- Consolidar selección de componentes y presupuesto

Actividades a realizar la próxima semana por Tomas Infante:

- Analizar primera torreta a nivel prototipo para pruebas.
- Test de fluides de los motores.

Dado que la semana siguiente tiene asociada la entrega del 5%. Avanzaremos bastante en eso y en la presentación correspondiente.

ANEXO:

https://youtube.com/shorts/ZFO-V5sZ5Ec?feature=share
