tomasinfante/Diseno-Electrico-Capstone/Bitacora/Bitácora_Semana_2.docx

Bitácora semana 2

Actividades realizadas en la semana por Pablo Del Campo:

- Investigación de literatura y estado del arte sobre algoritmos de revisión y procesamiento de imágenes (6 Horas)
- Investigación sobre MPC (3 Horas)
- Cotización de materiales necesarios para el proyecto (1 Hora)

Actividades realizadas en la semana por Juan Pablo Navarro:

- Compra de materiales asociados a la electrónica del proyecto, motores, drivers, cables, etc. (2 Horas)
- Experiencia práctica de uso y control de motor DC (1 Hora)
- Diseño plataforma en notebook y en 3D usando software Inventor (4 Horas)
- Investigación sobre tipos de rodamientos y engranajes (1 Hora)
- Revisión de literatura y otros proyectos 3D semejantes a lo que tenemos que realizar nosotros con el fin de buscar de inspiración (2 Horas)

Actividades realizadas en la semana por Tomas Infante:

- Experiencia práctica de uso y control de motor DC (1 Hora)
- Revisión de literatura sobre la electrónica y las razones para elegir los componentes que elegimos (5 Horas)
- Revisión de literatura y otros proyectos 3D semejantes a lo que tenemos que realizar nosotros con el fin de buscar de inspiración (3 Horas)
- Compra y cotización online de algunos componentes que solo estaban en China (1 Hora)

Dado que la próxima semana tenemos la primera presentación del curso, priorizaremos la entrega como grupo intentando distribuirnos el trabajo de manera homogénea. Dicho lo anterior esperamos usar al menos 21 Horas de eso, lo cual se distribuirá como 7 horas por integrante. Entonces definiremos este trabajo como el punteo que sigue:

- Analizar el problema y sus requerimientos, con especificaciones claras y coherentes al problema
- Analizar 2 o más posibles soluciones y justificar la elegida (Motor Stepper/Motor DC – Plataforma Diferencial/Plataforma Cartesiana – Kalman/Predictor αβ)
- Bosquejar un prototipo de la solución
- Hacer un diagrama de bloques funcional y adecuado al problema
- Hacer una planificación semestral

Actividades particulares extra:

- Probar los componentes que tenemos en el laboratorio (Tomas Infante – 3 Horas)
- Terminar el diseño en inventor de la torreta (Juan Pablo Navarro – 3 Horas)
- Partir diseñando los primeros sistemas de control para los motores (Pablo Del Campo – 3 Horas)
