tomasinfante/Diseno-Electrico-Capstone/Bitacora/Bitácora_Semana_3.docx

Bitácora semana 3

Actividades realizadas en la semana por Pablo Del Campo:

- Armar el diagrama de bloques general del proyecto (2 horas)
- Investigación de arquitecturas de control para el proyecto (2 horas)
- Investigación de bibliografía acerca del procesamiento de imágenes que debe hacer nuestro proyecto (3 horas)
- Redacción informe, presentación y elaboración de la Carta Gantt (3 horas)

Actividades realizadas en la semana por Juan Pablo Navarro:

- Finalizar bosquejo del prototipo diseñado (1 horas)
- Analizar la solución de arquitectura independiente vs. diferencial para la parte mecánica del proyecto (1 hora)
- Escribir el análisis de las arquitecturas mecánicas y la decisión final en el informe (2 horas)
- Explicar y justificar en el informe el bosquejo del prototipo diseñado (2 horas)
- Probar los motores stepper Nema 17 comprados para el proyecto (4 horas)

Actividades realizadas en la semana por Tomas Infante:

- Realización de informe, presentación y carta Gantt (5 horas)
- Retiro sensores (1 hora)
- Revisión literatura sobre controladores aplicados a plantas similares a la estudiada (2 horas)
- Investigación sobre impresión 3D, márgenes, sensibilidad, materiales, precios, etc. (3 horas)

Actividades a realizar la próxima semana por Pablo Del Campo:

- Investigación especificaciones cámara raspberry v2
- Definir estrategia y algoritmo para detección de imagen.

Actividades a realizar la próxima semana por Juan Pablo Navarro:

- Consolidar selección de componentes y presupuesta
- Verificar componentes adquiridos
- Comenzar con el diseño mecánico definitivo de la plataforma

Actividades a realizar la próxima semana por Tomas Infante:

- Definir electrónica accionamiento y alimentación
- Revisión modelo matemático de la planta
- Implementar un sistema de PID simple para probar los motores con los encoders.

Además, todos tomaremos parte en la realización del informe para el avance de 5% del proyecto.
