tomasinfante/Diseno-Electrico-Capstone/(commit log)

2026-09-08 Agrega diseños 3D
    [AS5600Mount_nema17.3mf, AS5600Mount_nema17.stl, BASE_V10.3mf, BASE_V10.stl, CAP_V10.stl, LOWER_ARM_PULLEY_SUPPORT_V10.stl, LOWER_ARM_V10.stl, LOWER_ARM_V11_by_mikeq.stl]
2026-09-09 Agrega script Picamera2 para captura de foto en Raspberry Pi
2026-10-25 Agrega diseño LQR + Kalman y modelo de cámara para pan-tilt
    - lqr_pan_tilt.py: LQI discreto por eje con prealimentación de velocidad,
    filtro de Kalman del objetivo (con manejo de oclusiones), conversión
    píxel -> ángulo y modelo exacto de la cámara en convención OpenCV
    (rotación base-cámara, proyección y ángulos absolutos del objetivo).
    - lqr_sim.png: simulación de seguimiento en pan y tilt con oclusión.
2026-10-25 Agrega interfaz web de seguimiento para Raspberry Pi
    Dashboard Flask con video en vivo, error del objetivo respecto al centro
    (px y grados), resolución de la imagen y FPS.
2026-10-25 Fuerza modo de sensor 1640x1232 (FOV completo) en la cámara
    - interfaz.py y prueba_seguimiento_pelota.py piden el modo 1640x1232
    (binning 2x2 sobre el sensor completo) escalado a 640x480, para evitar
    que libcamera elija el modo nativo 640x480, que es un recorte (FOV ~26.5°).
    - interfaz.py: detección de láser verde y solo Picamera2.
    - lqr_pan_tilt.py: documenta que F_X ~ 530 px corresponde a este modo.
2026-11-02 Envía el error por UART y detecta láser rojo en la interfaz
    - interfaz.py envía ex, ey [px] por la UART de la Raspberry (GPIO14) en
    paquetes de 6 bytes: 0xAA 0x55 + dos int16 little-endian.
    - La detección pasa de láser verde a rojo (dos rangos de tono en HSV).
    - Cámara a 50 FPS y JPEG al 40 % para bajar la latencia.
    - Reemplaza tomar_foto.py por prueba_camara.py, que lista los modos del sensor.
2026-11-02 Quita la conversión de píxeles y el main de lqr_pan_tilt.py
    La conversión de píxeles a error angular ahora vive en el firmware del
    ESP32 (KalmanPlusController).
2026-11-02 Agrega firmware ESP-IDF del controlador pan-tilt (KalmanPlusController)
    Proyecto PlatformIO con ESP-IDF en C++ para el ESP32:
    - Recibe por UART2 (GPIO16) el error ex, ey que envía interfaz.py y
    detecta la pérdida del objetivo por timeout.
    - Control PI de velocidad por eje a 50 Hz, a la par de la cámara.
    - Generador de pasos con GPTimer a 20 kHz y acumulador de fase para los
    dos DRV8825 (pines según el pinout final de la PCB).
2026-11-02 Agrega la Entrega 2 y las tablas de la comunicación
    Tablas LaTeX con el período medido de la comunicación UART y la
    velocidad angular máxima que admite.
2026-11-09 Pasa KalmanPlusController a C con módulos independientes
    Reemplaza main.cpp por módulos en C, cada uno con su header, un struct
    de configuración y una función de inicio, sin depender de los demás:
    - receptor_pi: recibe por UART el error ex, ey que envía interfaz.py.
    - camara: convierte el error de píxeles a ángulo.
    - control_pi: PI de velocidad de un eje.
    - motor_pasos: genera los pasos de un motor con DRV8825. Los micropasos
    son parámetro del motor y fijan M0-M2 y los pasos por vuelta a la vez.
    main.c concentra la configuración, instancia los módulos y los conecta en
    la tarea de control. ACTIVAR_CONTROL sigue en false, como en main.cpp.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
2026-11-11 Agrega etapas del programa y dirección del objetivo respecto del gimbal
    Raspberry (interfaz.py):
    - Etapas Detenido, Calibrar, Búsqueda y Seguimiento, con botones en la
    página para las tres primeras; Búsqueda pasa a Seguimiento al detectar
    el objetivo por primera vez.
    - La etapa viaja en el segundo byte de la cabecera UART (0x01..0x04).
    - Detección del objetivo como triángulo rojo y ajustes editables desde
    la página.
    ESP32 (KalmanPlusController):
    - receptor_pi lee la etapa de la cabecera y la expone con receptorPiEtapa.
    - camara calcula la dirección del objetivo en el marco del gimbal
    (rg = RTot(α, β)·Pᵀ·rc) y main usa αobj - α y βobj - β como error del PI.
    - Agrega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
2026-11-11 Agrega Kalman, barrido de búsqueda y parámetros del control por UART
    ESP (KalmanPlusController):
    - Kalman.c/h: filtro de Kalman por eje que estima la dirección y la
    velocidad del objetivo, y sigue prediciendo mientras la cámara no lo ve.
    - barrido.c/h: barrido senoidal suave de cada eje para la etapa Búsqueda.
    - main.c: mueve los motores según la etapa (Detenido, Calibrar, Búsqueda,
    Seguimiento) usando el Kalman, el barrido y el PI.
    - receptor_pi: nuevo paquete de parámetros (0xAA 0x10, 13 bytes con suma
    de comprobación) con omegaMax y las ganancias PI de cada eje.
    - control_pi: permite cambiar las ganancias en marcha y reiniciar la integral.
    - Detect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
2026-11-12 Mejora la detección del avión y separa el video de la detección
    - Máscara de rojo en dos niveles de saturación (descarta labios y piel)
    - Proporción con el rectángulo mínimo y filtro de ocupación
    - Seguidor con coherencia temporal y vista de máscara con descartes
    - Dibujo y JPEG en un hilo aparte (hasta 25 FPS) para que la detección siga a 50 Hz
2026-11-12 Calibrar libera los motores y fija el ángulo cero al salir
